mahmudulislam299/Hit-The-Rabbit-Game-Using-only-Logic-Circuit/(list of files, drawings)

Other design files:
de_Project_clean_2.pdsprj
hit_the_head.pdsprj
undertand de.pdsprj
